Pdpriya62/Lab-dye-Testing-/images/WHITE_20261113_002053.jpg

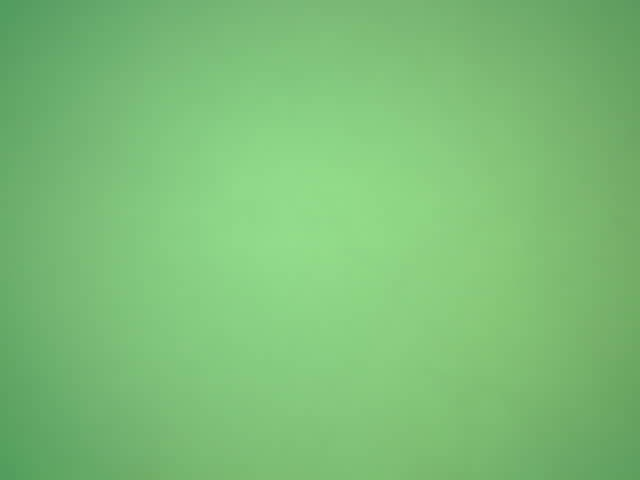
images/WHITE_20261113_002053.jpg
