Pdpriya62/Lab-dye-Testing-/images/WHITE_20261113_001548_annotated.jpg

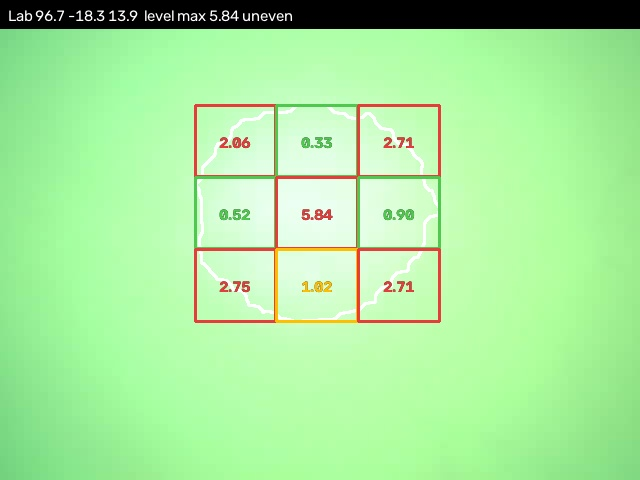
images/WHITE_20261113_001548_annotated.jpg
