Pdpriya62/Lab-dye-Testing-/poster/poster_A3.pdf

# A Low-Cost Multi-Sensor IoT Rig for Process-Aware Lab-Dip Shade Assessment

## 1 Aim

To build a low-cost IoT rig that records every colour reading of a textile lab dip together with the dye-bath and room conditions that produced it, tagged with the sample ID, so that a failed dip can be traced to a likely cause instead of guessed at.

## 2 Problem Statement

A lab dip is a small swatch dyed to the buyer's shade before bulk dyeing.
When a dip is rejected, the recipe is blamed, yet bath temperature, lighting and humidity also shift the shade.
Labs rarely record these beside the colour reading, so a rejected dip has no cause attached. Each extra round wastes dye, water and a day.
Spectrophotometers are costly and do not log the process.

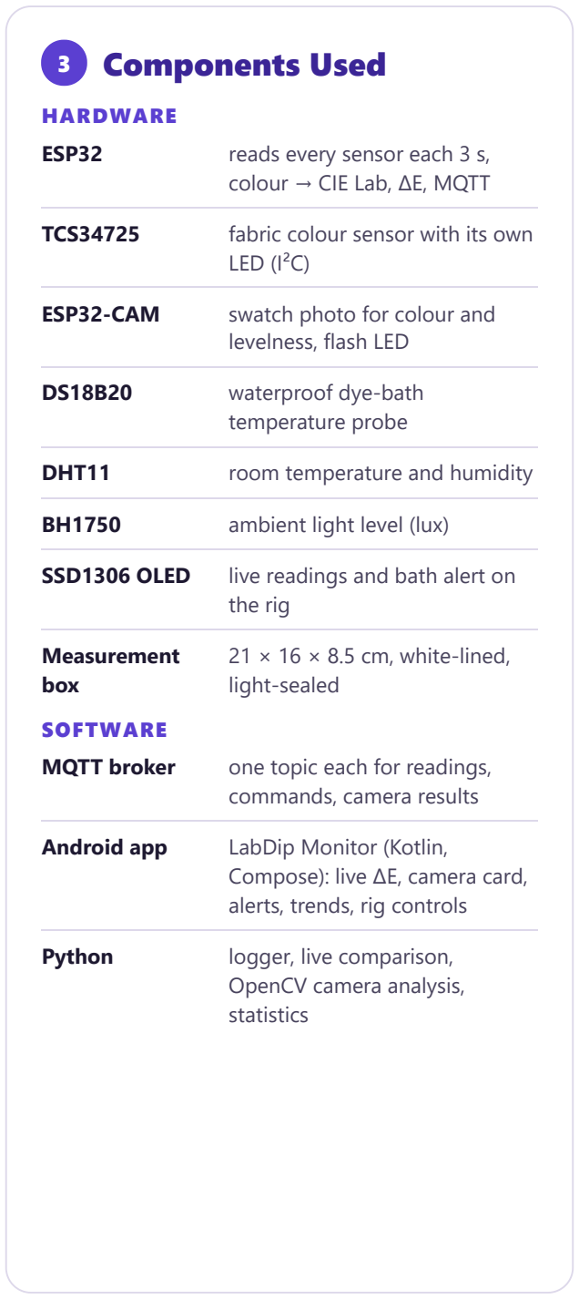
[picture p3: figure]
3 Components Used; HARDWARE; ESP32; reads every sensor each 3 s,; colour → CIE Lab, ΔE, MQTT; LED (I²C); ESP32-CAM; swatch photo for colour and; levelness, flash LED; waterproof dye-bath; temperature probe; DHT11; room temperature and humidity; ambient light level (lux); the rig; Measurement box; 21 × 16 × 8.5 cm, white-lined, light-sealed; SOFTWARE; MQTT broker; one topic each for readings,; commands, camera results; Android app; LabDip Monitor (Kotlin,; Compose): live ΔE, camera card, alerts, trends, rig controls; Python; logger, live comparison,; OpenCV camera analysis, statistics

TCS34725 | fabric colour sensor with its own
SSD1306 OLED | live readings and bath alert on

## 4 Working Principle

Sense
colour, bath,
room, light

ESP32
Lab, ΔE, bath
alert

MQTT
JSON every 3 s

↓ subscribed by ↓
App
ΔE, PASS / FAIL,
commands

Laptop
log, compare,
analyse

ESP32-CAM
photo → Lab,
grid

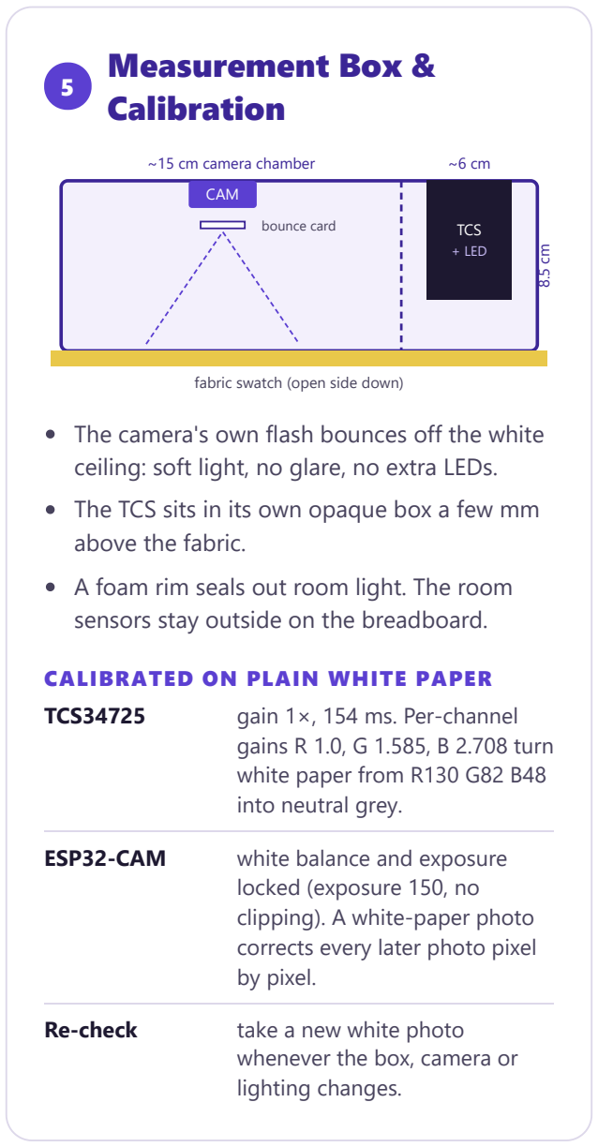
[picture p4: figure]
Measurement Box & Calibration; CAM; bounce card; TCS; + LED; fabric swatch (open side down); ~15 cm camera chamber; above the fabric.; sensors stay outside on the breadboard.; CALIBRATED ON PLAIN WHITE PAPER; TCS34725; gain 1×, 154 ms. Per-channel; gains R 1.0, G 1.585, B 2.708 turn white paper from R130 G82 B48 into neutral grey.; ESP32-CAM; white balance and exposure; locked (exposure 150, no clipping). A white-paper photo corrects every later photo pixel by pixel.; Re-check; take a new white photo; whenever the box, camera or lighting changes.

The camera's own flash bounces off the white ceiling: soft light, no glare, no extra LEDs. The TCS sits in its own opaque box a few mm

A foam rim seals out room light. The room

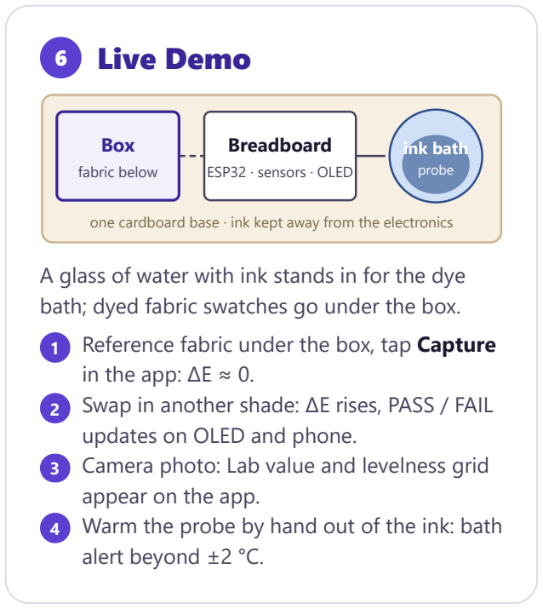
[picture p5: figure]
6 Live Demo; Box; fabric below; Breadboard; ESP32 · sensors · OLED; ink bath probe; in the app: ΔE ≈ 0.; updates on OLED and phone.; appear on the app.; alert beyond ±2 °C.

one cardboard base · ink kept away from the electronics
A glass of water with ink stands in for the dye bath; dyed fabric swatches go under the box.

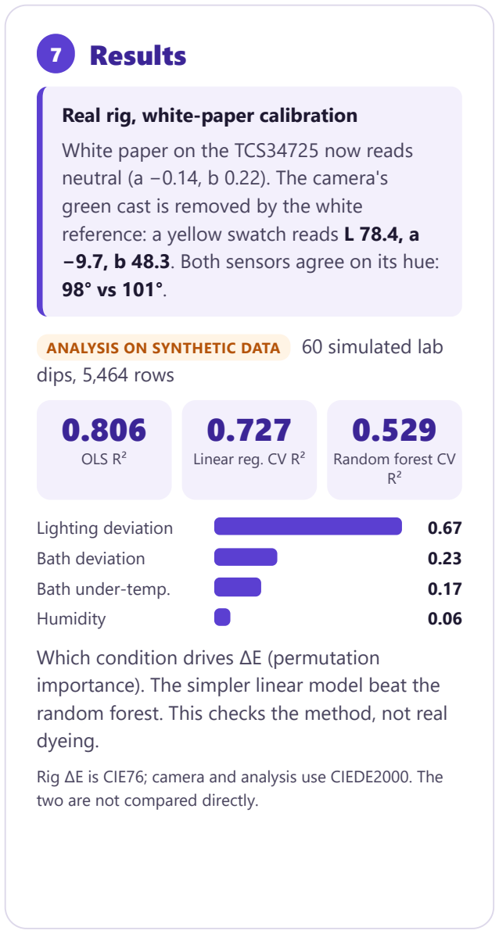
[picture p6: figure]
7 Results; Real rig, white-paper calibration White paper on the TCS34725 now reads neutral (a −0.14, b 0.22). The camera's green cast is removed by the white; dips, 5,464 rows 0.806; OLS R²; Linear reg. CV R²; Random forest CV R²; Lighting deviation; Bath deviation; Bath under-temp.; Humidity; Which condition drives ΔE (permutation; dyeing.; two are not compared directly.

reference: a yellow swatch reads L 78.4, a −9.7, b 48.3. Both sensors agree on its hue:

ANALYSIS ON SYNTHETIC DATA 60 simulated lab

importance). The simpler linear model beat the random forest. This checks the method, not real

Rig ΔE is CIE76; camera and analysis use CIEDE2000. The

TE AM 11
Priyadarshini Prasad
Niharika K P
Nidhi Santosh Nayak
Nischita M
Ganavi J

GUIDE
Aishwarya Singh Gautam
Assistant Professor

IOT DAY · RV UNIVERS I T Y

### Team 11 · School of Computer Science and Engineering, RV University, Bengaluru

Colour: TCS34725 counts ÷ clear channel, scaled to 0–255, corrected by calibration gains, then sRGB → XYZ (D65) → CIE L*a*b*.

1

Target: the reference swatch is captured from the app. Every later swatch gets ΔE and PASS / FAIL against it.

2

Process: bath temperature (alert beyond ±2 °C of set point), room temperature, humidity and light go in the same record.

3

Camera: each photo is corrected pixel by pixel with a white-paper photo, the fabric patch is found automatically and a 3 × 3 grid checks dyeing levelness. Results show on the app's camera card.

4

Analysis: correlation, OLS with ANOVA and cross-validated regression rank the most likely cause of a colour deviation.

5

Safety: every command is range-checked. A missing sensor sends nothing, never a fake value.

6

Reference fabric under the box, tap Capture

Swap in another shade: ΔE rises, PASS / FAIL

Camera photo: Lab value and levelness grid

Warm the probe by hand out of the ink: bath
