Pdpriya62/Lab-dye-Testing-/android-app/frontend.md

# Frontend Design Guidelines

## Visual direction (2026-11-01, supersedes the moss palette and the grey-booth chrome below)
- **Violet glass**, from the reference mock-up `original-45e9928e108b001110bff9260d116afe.webp`: backdrop `Dusk` #1A1236 to `Night` #0D0920, `Orchid` #D58CFF spotlight top right, drifting `Violet` #8B5CF6 and `Indigo` #3B2A8C dye blobs, and a faint rippling woven-thread texture (all in `Backdrop`, drawn on `Canvas`).
- Cards fade from `Glass` (white 8%) to `GlassViolet` (#7C52E0 at 33%), border `GlassEdge`. Text `Ink` #F6F3FF, `InkSoft` #C2BAD8, `InkFaint` #6E6690. Bottom bar `NavSurface` #150F2C.
- Accents, status colours and the N5 `SwatchSurround` stay as below.
- Onboarding: 5 feature slides on every launch, each with an animated orb in the feature's accent colour; the backdrop glow takes that colour.

## Visual direction (2026-10-29, superseded)
The team chose a reference mock-up (dark wellness-dashboard style; image kept outside the repo). The app follows it:
- **Dark only.** Warm near-black backdrop (`Night` #161714 to `Dusk` #22241F) with a soft moss glow (`Moss` #3E4636) behind the top of each screen.
- **Frosted glass cards**: 28 dp corners, white 8% fill fading to 4%, 1 dp white 10% border. No elevation except the alert banner.
- **Round glass icon buttons** (48 dp; selected 56 dp with a brighter rim), as in the mock-up's metric row and onboarding cluster.
- **Type**: screen titles in Instrument Serif italic (38 sp). Everything else in Archivo; numbers in condensed Archivo with tabular figures.
- **Accent per reading**: bath `Ember` #FF6B2C, ambient `Amber` #F7B634, humidity `Aqua` #3FD4EA, light `Lime` #C5E26A. Status colours stay `Pass` #7CCB95, `Marginal` #E3C15A, `Fail` #F08A8A, always with word + icon.
- **Live**: hero card with the metric buttons and a half-circle tick gauge (lit up to the value, long ticks at the limits), then the swatch, then 2×2 reading cards and the Lab card.
- **Trend**: text range tabs ("Last 20 / Last 100 / All") and stacked chart cards (icon, title, range, big value, footer).
- **Bottom bar**: Live, Trend, Samples, Settings; selected label bold.

**What is kept from the booth idea:** the fabric swatch always sits on a neutral N5 grey surround (`SwatchSurround` #777777, R=G=B), so the dark tinted chrome never touches the colour being judged. The grey-chrome token table below no longer applies. Layout, copy, motion and accessibility rules still do.

## Subject and primary job
The app is a pocket version of a **colour-matching viewing booth**. Its one job: tell a dyer at a glance whether this dip matches the target shade, and whether the bath is in range.

## Design idea
Dye labs judge shades in a booth with **neutral grey walls** (ISO 3664, Munsell N-greys) so nothing tints the eye. The UI follows the same rule: all chrome is strictly achromatic. **The only chroma on screen comes from the measured fabric colour and from status.** The swatch is the hero; everything else stays quiet.

Second borrowed object: the **lab-dip card**, where target and sample are mounted side by side. The Live screen shows a split swatch, target half and measured half, with ΔE set across the seam.

## Colour tokens
All chrome tokens are pure greys (R = G = B).

| Token | Light | Dark | Use |
|---|---|---|---|
| `booth` | `#BDBDBD` (≈ N7.5) | `#3B3B3B` (≈ N2.5) | screen background |
| `panel` | `#D4D4D4` | `#4A4A4A` | grouped readings |
| `ink` | `#000000` | `#FFFFFF` | primary text |
| `inkSoft` | `#2E2E2E` | `#D0D0D0` | secondary text (≥ 4.5:1 on `booth`) |
| `rule` | `#9E9E9E` | `#5C5C5C` | hairline dividers |
| `pass` | `#1F6B3A` | `#7CCB95` | PASS text/icon |
| `marginal` | `#7A5A00` | `#E3C15A` | marginal text/icon |
| `fail` | `#9C1C1C` | `#F08A8A` | FAIL, bath alert |

- Status colours appear only as text/icon colour and in the alert banner, never as background washes.
- Every status has a word and an icon (check / tilde / cross), so it reads without colour.
- Turn off Material You dynamic colour: a wallpaper tint would break the neutral-grey rule.

## Typography
One family: **Archivo** (Google Fonts, variable width + weight). Condensed widths suit dense instrument readouts; normal width reads well as body text.

| Role | Style | Size / line |
|---|---|---|
| ΔE readout | width 75, weight 700, tabular figures | 64 / 64 sp |
| Status word | width 100, weight 700 | 22 / 28 sp |
| Reading value | width 87, weight 600, tabular figures | 20 / 24 sp |
| Reading label | weight 400 | 13 / 18 sp |
| Body | weight 400 | 15 / 22 sp |

- Sentence case everywhere. No all-caps labels.
- Units sit next to values: "61.8 °C", "412 lx".
- Tabular figures on every number, so values don't jitter as they update.

## Live screen layout
```
+--------------------------------+
| S001  cotton, reactive red   [gear]   <- top bar; connection dot + "2 s ago"
+--------------------------------+
| +------------+---------------+ |
| |  target    |   measured    | |  split swatch, ~45% of screen height
| |            |               | |
| |         ΔE 1.42            | |  ΔE on the seam; ink picked by swatch luminance
| +------------+---------------+ |
| ~ Marginal   (pass at 1.0 or less)
+--------------------------------+
| Bath       61.8 °C   set 60 ±2 |  row turns `fail` colour + banner on alert
| Lab        52.3  10.1  -4.2    |
| Ambient    27.4 °C   58 %      |
| Light      412 lx              |
+--------------------------------+
```
- Labels left-aligned; values right-aligned in one column.
- Readings are rows inside one `panel`, split by `rule` hairlines, not separate cards.
- Corner radius by role: swatch 4 dp (it is a fabric card), panel 12 dp, buttons full pill.
- No elevation on content. Only the alert banner and dialogs are elevated.
- If no target is set, the swatch is full-width measured colour and ΔE sits at its bottom edge.

## Charts (Vico)
- Data lines in `ink`; threshold and setpoint lines in `inkSoft`, dashed; tolerance band in `rule` at 30% opacity.
- Readings that FAIL get a `fail` dot. No gradient fills under lines.
- Axis titles include units.

## Motion
- One deliberate motion: when a new reading arrives, the measured half of the swatch crossfades to the new colour (300 ms). The ΔE number updates without animation.
- Alert banner slides down from the top (200 ms).
- Respect the system "Remove animations" setting.

## Copy
- Errors state what happened and what to do: "Can't reach broker.hivemq.com. Check Wi-Fi or broker settings."
- Empty states invite action: "No samples yet. Readings appear here once the rig publishes."
- One verb per action across a flow: "Connect" button, "Connected" status.

## Accessibility
- Touch targets ≥ 48 dp.
- TalkBack: swatch announces "Measured colour red 182, green 40, blue 52. Delta E 1.42, marginal."
- Supports font scale up to 200%; Live scrolls rather than clipping.
