Pdpriya62/Lab-dye-Testing-/images/WHITE_20261112_233620_annotated.jpg

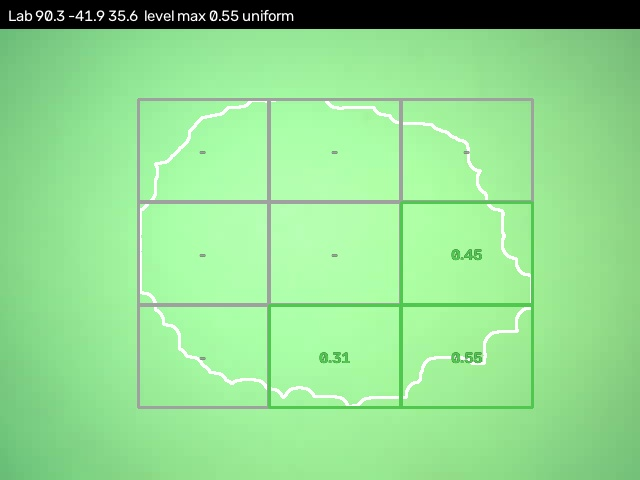
images/WHITE_20261112_233620_annotated.jpg
