Pdpriya62/Lab-dye-Testing-/images/WHITE_20261113_001339.jpg

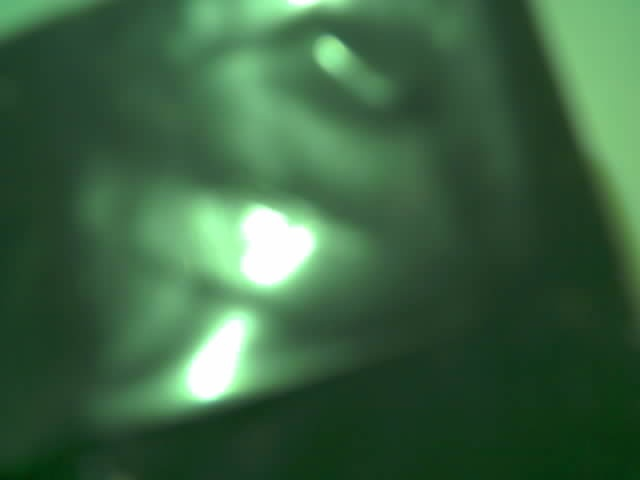
images/WHITE_20261113_001339.jpg
