Pdpriya62/Lab-dye-Testing-/images/WHITE_20261113_001452.jpg

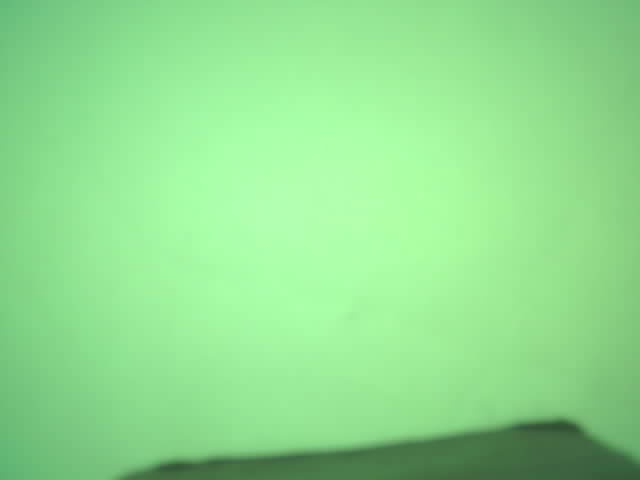
images/WHITE_20261113_001452.jpg
