Pdpriya62/Lab-dye-Testing-/test_real.csv

sample_id | timestamp | L | a | b | ambient_temp | humidity | light_lux | bath_temp | setpoint_c
T1 | 2026-10-29 10:00:00 | 25.2 | 2.1 | -21.8 | 27.5 | 50 | 1190 | 60.1 | 60
T2 | 2026-10-29 10:05:00 | 29.5 | 1.5 | -20.0 | 28.0 | 44 | 1500 | 57.2 | 60
T3 | 2026-10-29 10:10:00 | 44.0 | 60.0 | 38.0 | 28.5 | 62 | 1210 | 59.8 | 60
