Pdpriya62/Lab-dye-Testing-/sample_results.csv

sample_id | session_start | measured_at | fabric | dye_class | shade_name | dye_conc_pct_owf | liquor_ratio | setpoint_c | hold_time_min | target_L | target_a | target_b | measured_L | measured_a | measured_b | tcs_raw_R | tcs_raw_G | tcs_raw_B | tcs_raw_clear | rgb_R | rgb_G | rgb_B | delta_E_76 | delta_E_2000 | result | hold_mean_temp_c | hold_min_temp_c | hold_max_temp_c | hold_temp_std_c | mean_ambient_temp_c | mean_humidity_pct | mean_light_lux | ambient_temp_at_measure_c | humidity_at_measure_pct | light_lux_at_measure | main_deviation_driver | data_source
LD-001 | 2026-10-19 09:30:00 | 2026-10-19 10:44:00 | Viscose | Reactive | Leaf Green | 1.87 | 1:20 | 60 | 28 | 52 | -45 | 28 | 53.33 | -43.51 | 26.92 | 546 | 5482 | 1485 | 8864 | 47 | 145 | 79 | 2.27 | 1.42 | FAIL | 57.18 | 56.12 | 58.06 | 0.42 | 27.5 | 49.6 | 1187 | 27.6 | 47.8 | 1163 | dye_bath_temperature | synthetic
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
