Pdpriya62/Lab-dye-Testing-/results/correlation.png

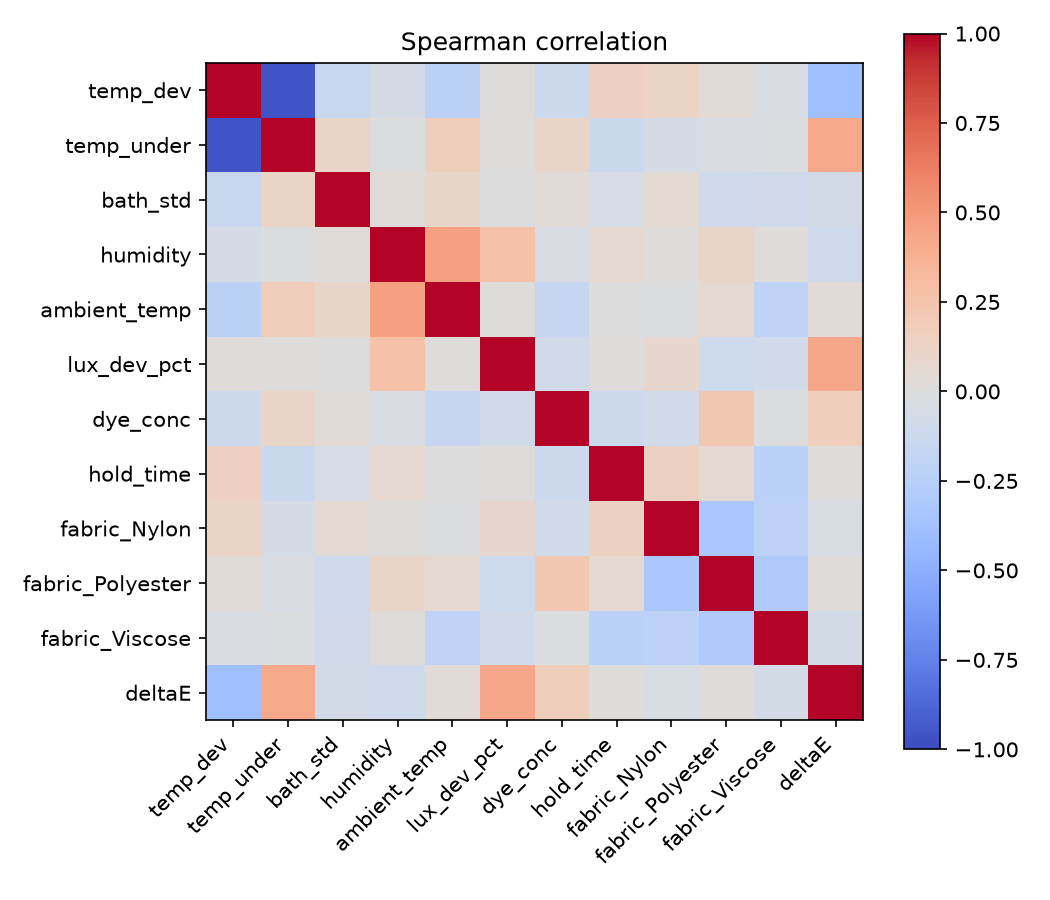
results/correlation.png
