Pdpriya62/Lab-dye-Testing-/results/feature_importance.png

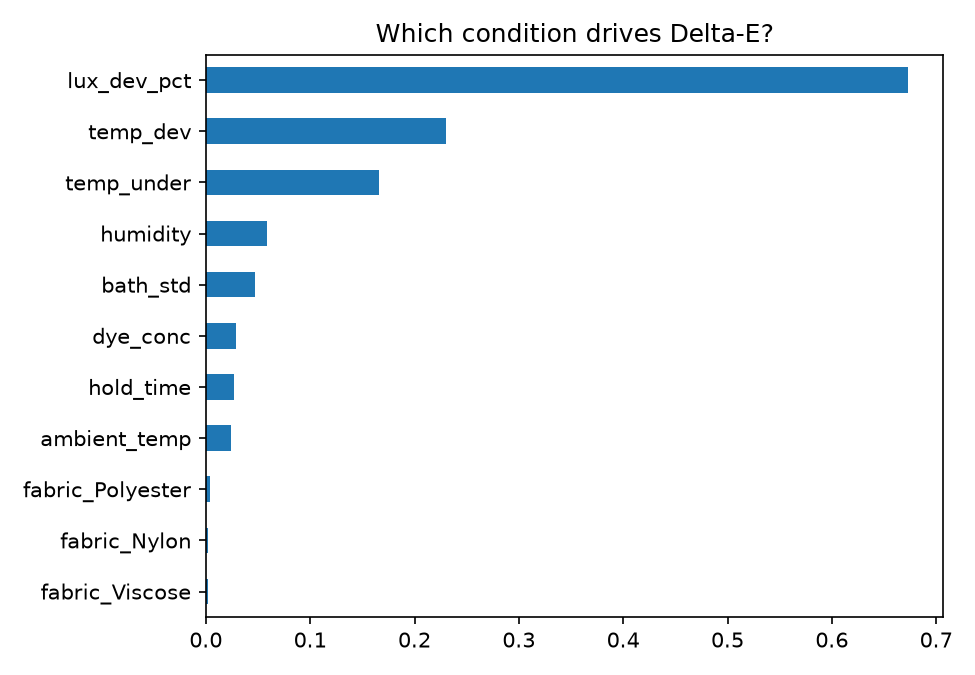
results/feature_importance.png
