Pdpriya62/Lab-dye-Testing-/results/pred_vs_actual.png

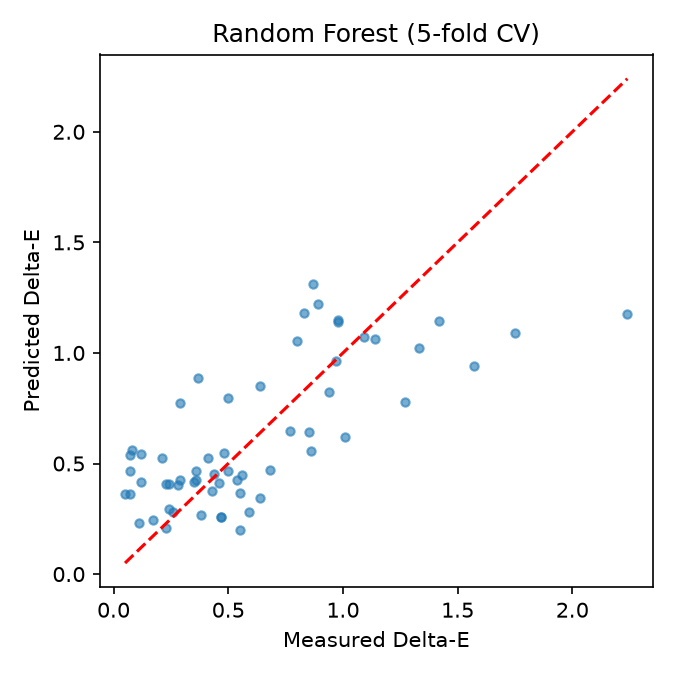
results/pred_vs_actual.png
