Pdpriya62/Lab-dye-Testing-/results/scatter.png

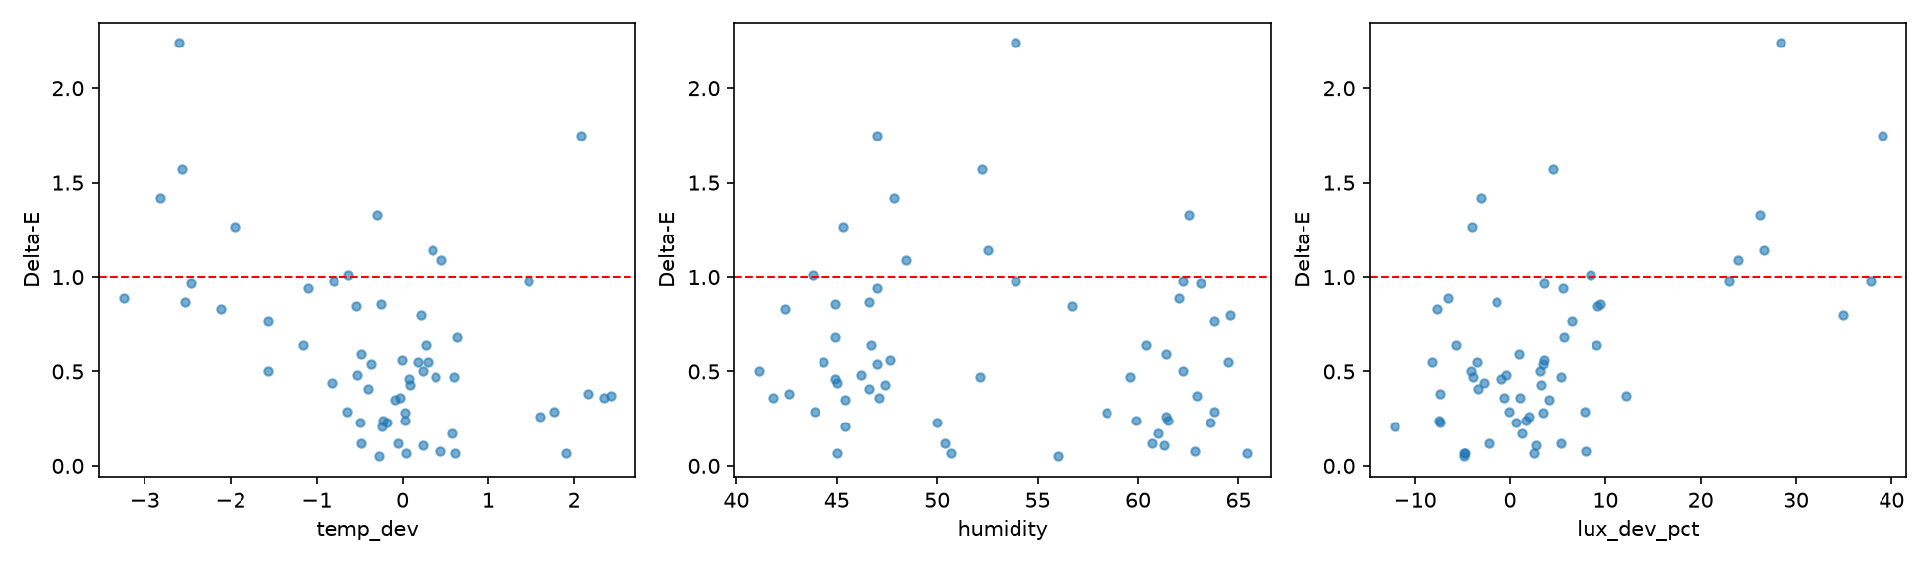
results/scatter.png
