Pdpriya62/Lab-dye-Testing-/lab_dip_esp32/lab_dip_esp32.ino

/*
 * Multi-Sensor IoT Framework for Textile Lab-Dip Testing  (Team 11)
 * ESP32 firmware: reads sensors, computes Delta-E on-device, shows on OLED, publishes JSON via MQTT.
 *
 * Libraries (Arduino Library Manager):
 *   Adafruit TCS34725, DHT sensor library (Adafruit), Adafruit Unified Sensor, BH1750 (by Christopher Laws),
 *   OneWire, DallasTemperature, Adafruit SSD1306, Adafruit GFX, PubSubClient, ArduinoJson
 *
 * Wiring: I2C SDA=GPIO21, SCL=GPIO22 (TCS34725, BH1750, OLED)
 *         DHT11 data=GPIO27
 *         DS18B20 data=GPIO4 with 4.7k pull-up to 3.3V
 *
 * Commands: type them in the Serial Monitor (115200 baud, newline terminated), or publish the same
 * text to MQTT_CMD_TOPIC (the LabDip Monitor app does this). Replies ("OK ..." or "ERR ...") go to
 * serial and to MQTT_ACK_TOPIC.
 * Serial commands:
 *   ID S001            set current Sample ID
 *   CAPTURE            store the CURRENT colour reading as the target shade
 *   TARGET 52.3 10.1 -4.2   set target Lab values manually
 *   BATH 60            set recipe bath temperature (C); alert if outside +/- BATH_TOL
 *   FABRIC cotton / DYE reactive_red / CONC 2.0   optional metadata added to every JSON
 *   PAUSE / RESUME     stop / restart publishing while the fabric is swapped (PAUSE, swap, ID S002, RESUME)
 */
#include <Wire.h>
#include <WiFi.h>
#include <PubSubClient.h>
#include <ArduinoJson.h>
#include <Adafruit_TCS34725.h>
#include <DHT.h>
#include <BH1750.h>
#include <OneWire.h>
#include <DallasTemperature.h>
#include <Adafruit_GFX.h>
#include <Adafruit_SSD1306.h>
#include <math.h>
#include <time.h>
#include "secrets.h"   // WIFI_SSID, WIFI_PASS; copy secrets.example.h if missing

// ---------- USER SETTINGS ----------
const char* MQTT_HOST = "broker.hivemq.com";   // public test broker; use your own for real trials
const int   MQTT_PORT = 1883;
const char* MQTT_TOPIC = "rvu/team11/labdip/data";   // make this unique to avoid other people's traffic
const char* MQTT_CMD_TOPIC = "rvu/team11/labdip/cmd"; // app -> rig commands; keep the same prefix as MQTT_TOPIC
const char* MQTT_ACK_TOPIC = "rvu/team11/labdip/ack"; // rig -> app replies
const char* MQTT_STATUS_TOPIC = "rvu/team11/labdip/status"; // retained "online"; broker sets "offline" (last will) if the rig drops
const unsigned long SAMPLE_INTERVAL_MS = 3000;       // 2-5 s as per methodology
const float BATH_TOL = 2.0;                          // +/- C alert window
// Per-channel calibration gains (fill in after Priya's calibration against reference swatches)
// 2026-11-12: white paper read R130 G82 B48 at GAIN_1X; gains make it neutral grey (130,130,130), red kept at 1.0 to limit clipping
float CAL_R = 1.0, CAL_G = 1.585, CAL_B = 2.708;
// -----------------------------------

#define ONE_WIRE_PIN 4
#define OLED_W 128
#define OLED_H 64

Adafruit_TCS34725 tcs(TCS34725_INTEGRATIONTIME_154MS, TCS34725_GAIN_1X);   // 4X saturated on white paper with the LED on
#define DHT_PIN 27
#define DHT_TYPE DHT11
DHT dht(DHT_PIN, DHT_TYPE);
BH1750 lightMeter;
OneWire oneWire(ONE_WIRE_PIN);
DallasTemperature ds18(&oneWire);
Adafruit_SSD1306 oled(OLED_W, OLED_H, &Wire, -1);
WiFiClient wifiClient;
PubSubClient mqtt(wifiClient);

String sampleId = "S001", fabric = "", dye = "";
float conc = 0;
float targetL = 50, targetA = 0, targetB = 0;
float bathSet = 60.0;
bool haveBath = false;
bool haveTarget = false;   // false until CAPTURE or TARGET; deltaE is against the 50/0/0 placeholder until then
bool tcsFound = false;
bool colourOk = false;     // true only when the last TCS34725 read returned light; no colour = nothing published
unsigned long lastSample = 0;
bool paused = false;       // PAUSE: keep reading and showing, but publish nothing, so a fabric swap is not logged under the old sample ID

struct Reading { float r, g, b, L, a, bb, dE, ambT, hum, press, lux, bath; bool alert; };
Reading cur;

// ---------- Colour maths: sRGB -> XYZ(D65) -> CIE Lab, then CIE76 Delta-E ----------
float lin(float c) { c /= 255.0; return (c <= 0.04045) ? c / 12.92 : pow((c + 0.055) / 1.055, 2.4); }
float fLab(float t) { return (t > 0.008856) ? cbrt(t) : (7.787 * t + 16.0 / 116.0); }
void rgb2lab(float R, float G, float B, float &L, float &a, float &b) {
  float r = lin(R), g = lin(G), bl = lin(B);
  float X = (0.4124564 * r + 0.3575761 * g + 0.1804375 * bl) / 0.95047;
  float Y = (0.2126729 * r + 0.7151522 * g + 0.0721750 * bl) / 1.00000;
  float Z = (0.0193339 * r + 0.1191920 * g + 0.9503041 * bl) / 1.08883;
  float fx = fLab(X), fy = fLab(Y), fz = fLab(Z);
  L = 116.0 * fy - 16.0; a = 500.0 * (fx - fy); b = 200.0 * (fy - fz);
}
float deltaE76(float L1, float a1, float b1, float L2, float a2, float b2) {
  return sqrt((L1 - L2) * (L1 - L2) + (a1 - a2) * (a1 - a2) + (b1 - b2) * (b1 - b2));
}

// ---------- Sensors ----------
float median3(float x, float y, float z) { return max(min(x, y), min(max(x, y), z)); }

void readAll() {
  if (!tcsFound) tcsFound = tcs.begin();   // sensor plugged in after boot
  // Median of 3 reads per channel: one bumped or flickering read no longer moves deltaE (~0.5 s total)
  float ch[3][3];
  int n = 0;
  for (int i = 0; tcsFound && i < 3; i++) {
    uint16_t r = 0, g = 0, b = 0, c = 0;
    tcs.getRawData(&r, &g, &b, &c);
    if (c == 0) continue;   // dark or failed read
    // normalise by clear channel -> 0..255
    ch[n][0] = constrain((float)r / c * 255.0 * CAL_R, 0, 255);
    ch[n][1] = constrain((float)g / c * 255.0 * CAL_G, 0, 255);
    ch[n][2] = constrain((float)b / c * 255.0 * CAL_B, 0, 255);
    n++;
  }
  // A missing or unplugged sensor reads all zeros; publishing that would show a fake black sample
  colourOk = tcsFound && n == 3;
  if (!colourOk) { tcsFound = false; return; }
  float R = median3(ch[0][0], ch[1][0], ch[2][0]);
  float G = median3(ch[0][1], ch[1][1], ch[2][1]);
  float B = median3(ch[0][2], ch[1][2], ch[2][2]);
  cur.r = R; cur.g = G; cur.b = B;
  rgb2lab(R, G, B, cur.L, cur.a, cur.bb);
  cur.dE = deltaE76(cur.L, cur.a, cur.bb, targetL, targetA, targetB);
  float t_amb = dht.readTemperature(), h_amb = dht.readHumidity();
  cur.ambT = t_amb;   // NAN when the DHT11 read fails; publishReading() then leaves the field out
  cur.hum = h_amb;
  float lx = lightMeter.readLightLevel();
  cur.lux = lx < 0 ? NAN : lx;   // BH1750 returns a negative value on error
  ds18.requestTemperatures();
  float t = ds18.getTempCByIndex(0);
  cur.bath = (t == DEVICE_DISCONNECTED_C) ? NAN : t;
  cur.alert = haveBath && !isnan(cur.bath) && fabs(cur.bath - bathSet) > BATH_TOL;
}

// ---------- Display ----------
void showOLED() {
  oled.clearDisplay(); oled.setTextSize(1); oled.setTextColor(SSD1306_WHITE);
  oled.setCursor(0, 0);  oled.printf("ID:%s dE:%.1f", sampleId.c_str(), cur.dE);
  oled.setCursor(0, 11);
  if (colourOk) oled.printf("RGB %d %d %d", (int)cur.r, (int)cur.g, (int)cur.b);
  else oled.print("No colour sensor");
  oled.setCursor(0, 22); oled.printf("Bath: %.1f C", cur.bath);
  oled.setCursor(0, 33); oled.printf("Amb: %.1fC %.0f%%", cur.ambT, cur.hum);
  oled.setCursor(0, 44); oled.printf("Light: %.0f lx", cur.lux);
  oled.setCursor(0, 55); oled.print(cur.alert ? "!! BATH TEMP ALERT !!" : paused ? "PAUSED: swap fabric" : (mqtt.connected() ? "MQTT ok" : "MQTT offline"));
  oled.display();
}

// ---------- Network ----------
void connectWiFi() {
  static bool started = false, timeSet = false;
  static unsigned long lastTry = 0;
  if (WiFi.status() == WL_CONNECTED) {
    if (!timeSet) {
      Serial.print("WiFi ok, IP "); Serial.println(WiFi.localIP());
      configTime(19800, 0, "pool.ntp.org");  // IST = UTC+5:30
      timeSet = true;
    }
    return;
  }
  if (started && millis() - lastTry < 15000) return;   // let the running attempt finish
  lastTry = millis();
  if (!started) {
    // begin() only once: calling it again mid-attempt gives "sta is connecting, cannot set config"
    WiFi.mode(WIFI_STA);
    int n = WiFi.scanNetworks();   // scan before begin(), a scan during a connect attempt also fails
    Serial.printf("Networks seen (%d):\n", n);
    for (int i = 0; i < n; i++) Serial.printf("  '%s' ch%d %ddBm\n", WiFi.SSID(i).c_str(), WiFi.channel(i), WiFi.RSSI(i));
    WiFi.setAutoReconnect(true);
    WiFi.begin(WIFI_SSID, WIFI_PASS);
    started = true;
  } else {
    // 1 = SSID not visible (wrong name or 5 GHz), 4 = connect failed (usually wrong password), 6 = disconnected
    // setAutoReconnect retries on its own; calling reconnect() here gives "sta is connecting, return error"
    Serial.printf("WiFi not connected, status %d, still trying\n", WiFi.status());
    return;
  }
  unsigned long t0 = millis();
  while (WiFi.status() != WL_CONNECTED && millis() - t0 < 10000) delay(250);
}
void connectMQTT() {
  if (mqtt.connected() || WiFi.status() != WL_CONNECTED) return;
  String cid = "labdip-" + String((uint32_t)ESP.getEfuseMac(), HEX);
  // Last will: if the ESP32 loses power or Wi-Fi, the broker publishes "offline" for it after the keep-alive
  if (mqtt.connect(cid.c_str(), MQTT_STATUS_TOPIC, 0, true, "offline")) {
    mqtt.publish(MQTT_STATUS_TOPIC, "online", true);
    mqtt.subscribe(MQTT_CMD_TOPIC);
  }
}
String isoTime() {
  struct tm t;
  if (!getLocalTime(&t, 50)) return "1970-01-01T00:00:00";
  char buf[25]; strftime(buf, sizeof(buf), "%Y-%m-%dT%H:%M:%S", &t); return String(buf);
}
void publishReading() {
  StaticJsonDocument<512> d;
  d["sample_id"] = sampleId; d["timestamp"] = isoTime();
  d["deltaE"] = round(cur.dE * 100) / 100.0;
  d["R"] = (int)cur.r; d["G"] = (int)cur.g; d["B"] = (int)cur.b;
  d["L"] = round(cur.L * 100) / 100.0; d["a"] = round(cur.a * 100) / 100.0; d["b"] = round(cur.bb * 100) / 100.0;
  if (!isnan(cur.ambT)) d["ambient_temp"] = round(cur.ambT * 10) / 10.0;
  if (!isnan(cur.hum)) d["humidity"] = round(cur.hum * 10) / 10.0;
  if (!isnan(cur.lux)) d["light_lux"] = round(cur.lux);
  if (!isnan(cur.bath)) d["bath_temp"] = round(cur.bath * 10) / 10.0;
  d["bath_alert"] = cur.alert;
  d["setpoint_c"] = bathSet;
  d["target_L"] = round(targetL * 100) / 100.0; d["target_a"] = round(targetA * 100) / 100.0; d["target_b"] = round(targetB * 100) / 100.0;
  d["target_set"] = haveTarget;
  if (fabric.length()) d["fabric"] = fabric;
  if (dye.length()) d["dye"] = dye;
  if (conc > 0) d["dye_conc"] = conc;
  char out[512]; size_t n = serializeJson(d, out, sizeof(out));
  mqtt.publish(MQTT_TOPIC, (const uint8_t*)out, n, false);
  Serial.println(out);  // also print to serial so you can log without Wi-Fi
}

// ---------- Commands (serial and MQTT) ----------
// MQTT commands come from a public broker, so every argument is checked before it changes state.
bool okText(const String &v) {   // sample ID, fabric, dye: same whitelist as the app's parser
  if (v.length() < 1 || v.length() > 24) return false;
  for (size_t i = 0; i < v.length(); i++) {
    char ch = v[i];
    if (!(isalnum(ch) || ch == ' ' || ch == '_' || ch == '.' || ch == '-')) return false;
  }
  return true;
}
bool okNum(const String &v, float lo, float hi, float &out) {
  char *end; out = strtof(v.c_str(), &end);
  return v.length() && *end == '\0' && !isnan(out) && out >= lo && out <= hi;
}

String runCommand(String line) {
  line.trim();
  int sp = line.indexOf(' ');
  String cmd = sp < 0 ? line : line.substring(0, sp); cmd.toUpperCase();
  String arg = sp < 0 ? "" : line.substring(sp + 1); arg.trim();
  float v;
  if (cmd == "ID") {
    if (!okText(arg)) return "ERR ID needs 1-24 letters, digits, space, _ . -";
    sampleId = arg; return "OK sample=" + sampleId;
  }
  if (cmd == "CAPTURE") {
    if (!colourOk) return "ERR no colour reading to capture";
    targetL = cur.L; targetA = cur.a; targetB = cur.bb; haveTarget = true;
    char buf[48]; snprintf(buf, sizeof(buf), "OK target Lab=%.2f %.2f %.2f", targetL, targetA, targetB); return buf;
  }
  if (cmd == "TARGET") {
    float L, A, B; char extra;
    if (sscanf(arg.c_str(), "%f %f %f %c", &L, &A, &B, &extra) != 3) return "ERR usage: TARGET L a b";
    if (isnan(L) || isnan(A) || isnan(B) || L < 0 || L > 100 || A < -128 || A > 128 || B < -128 || B > 128)
      return "ERR L 0-100, a and b -128 to 128";
    targetL = L; targetA = A; targetB = B; haveTarget = true;
    char buf[48]; snprintf(buf, sizeof(buf), "OK target Lab=%.2f %.2f %.2f", targetL, targetA, targetB); return buf;
  }
  if (cmd == "BATH") {
    if (!okNum(arg, 0, 130, v)) return "ERR BATH needs 0-130 C";
    bathSet = v; haveBath = true;
    char buf[40]; snprintf(buf, sizeof(buf), "OK bath=%.1f +/- %.1f", bathSet, BATH_TOL); return buf;
  }
  if (cmd == "FABRIC") { if (!okText(arg)) return "ERR FABRIC needs 1-24 letters, digits, space, _ . -"; fabric = arg; return "OK fabric=" + fabric; }
  if (cmd == "DYE")    { if (!okText(arg)) return "ERR DYE needs 1-24 letters, digits, space, _ . -"; dye = arg; return "OK dye=" + dye; }
  if (cmd == "CONC") {
    if (!okNum(arg, 0, 100, v)) return "ERR CONC needs 0-100 %";
    conc = v; char buf[24]; snprintf(buf, sizeof(buf), "OK conc=%.2f", conc); return buf;
  }
  if (cmd == "PAUSE")  { paused = true;  return "OK paused, sample=" + sampleId; }
  if (cmd == "RESUME") { paused = false; return "OK resumed, sample=" + sampleId; }
  return "ERR unknown command";
}

void handleSerial() {
  if (!Serial.available()) return;
  String line = Serial.readStringUntil('\n'); line.trim();
  if (!line.length()) return;
  Serial.println(runCommand(line));
}

void onMqttMessage(char *topic, byte *payload, unsigned int len) {
  if (strcmp(topic, MQTT_CMD_TOPIC) != 0) return;
  if (len == 0 || len > 64) return;   // size cap: real commands are short
  char line[65];
  for (unsigned int i = 0; i < len; i++) {
    if (payload[i] < 32 || payload[i] > 126) return;   // printable ASCII only
    line[i] = (char)payload[i];
  }
  line[len] = '\0';
  String reply = runCommand(String(line));
  Serial.println(String("MQTT> ") + line + " -> " + reply);   // Serial Monitor sees app commands too
  mqtt.publish(MQTT_ACK_TOPIC, reply.c_str());
  if (reply.startsWith("OK")) lastSample = millis() - SAMPLE_INTERVAL_MS;   // publish a fresh reading now
}

void setup() {
  Serial.begin(115200);
  Wire.begin(21, 22);
  tcsFound = tcs.begin();
  if (!tcsFound) Serial.println("TCS34725 not found");
  dht.begin();
  if (!lightMeter.begin()) Serial.println("BH1750 not found");
  ds18.begin();
  if (!oled.begin(SSD1306_SWITCHCAPVCC, 0x3C)) Serial.println("OLED not found");
  oled.clearDisplay(); oled.setCursor(0, 0); oled.setTextColor(SSD1306_WHITE); oled.println("Connecting..."); oled.display();
  connectWiFi();
  mqtt.setServer(MQTT_HOST, MQTT_PORT);
  mqtt.setBufferSize(512);   // default 256 B silently drops full payloads
  mqtt.setCallback(onMqttMessage);
  mqtt.setKeepAlive(10);   // broker notices a dead rig in ~15 s
  Serial.println("Ready. Commands: ID, CAPTURE, TARGET, BATH, FABRIC, DYE, CONC");
}

void loop() {
  handleSerial();
  connectWiFi();   // reconnects when down; once connected it starts NTP (returns at once after that)
  connectMQTT();
  mqtt.loop();
  if (millis() - lastSample >= SAMPLE_INTERVAL_MS) {
    lastSample = millis();
    readAll(); showOLED();
    if (paused) Serial.println("Paused; nothing published (send RESUME)");
    else if (colourOk) publishReading();
    else Serial.println("No colour reading (TCS34725 missing or dark); nothing published");
  }
}
