Pdpriya62/Lab-dye-Testing-/(commit log)

2026-10-29 Add firmware, logger, analysis and live comparision scripts
    [compared_log.csv, model_metrics.csv, sample_results.csv, sensor_readings.csv, test_real.csv]
2026-10-29 chore: move firmware into lab_dip_esp32/ sketch folder
    Arduino IDE requires the .ino to sit in a folder of the same name.
2026-10-29 docs(android-app): add planning docs for LabDip Monitor app
    PRD, app flow, UI guidelines, architecture, database, security, progress and CLAUDE.md for the Kotlin/Compose MQTT client.
2026-10-29 feat(android-app): add LabDip Monitor Android app and firmware MQTT fixes
    App (android-app/): Kotlin + Jetpack Compose subscriber for the rig's MQTT
    topic. Live gauge with split target/measured swatch, trend charts, sample
    history with CSV export, settings with Keystore-encrypted broker password.
    Every payload is validated (size cap, strict decode, range checks, text
    whitelist) before it reaches Room. Includes tools/fake_rig.py for testing
    without hardware, unit tests and in-memory Room tests.
    Firmware: raise PubSubClient buffer to 512 B (the 256 B default silently
    dropped full payloads); publish target_L/a/b and target_set so the app
    knows whether deltaE is measured against a real target;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
2026-10-30 Added AI-Thinker ESP32-CAM with OV2640 camera
2026-10-30 Add ESP32-CAM capture firmware and colour measurement script
2026-10-30 Move camera files into camera folder
2026-11-01 docs: add demo guide, pin check sketch and trial data
    demo.md explains wiring, serial commands, the Python scripts, the app and the demo flow. pin_check scans ESP32 pins for each sensor.
    [compared_log.csv, trials_real.csv]
2026-11-01 feat(android-app): rig controls, rig presence, violet UI and firmware MQTT commands
    App
    - Violet glass re-skin with animated textile backdrop; 5-slide feature intro on every launch
    - Rig controls screen: capture, target Lab, sample ID, fabric, dye, concentration, bath setpoint, reply log
    - Rig presence: red "Rig offline" from MQTT last will or reading age; amber "No new data"
    - Connect over IPv4 (broker IPv6 refused 1883); fix swipe layer showing through Samples cards
    - Release signing from gitignored keystore.properties; release APK 2.3 MB
    Firmware
    - Commands over MQTT (cmd/ack topics) sharing one validated handler with serial
    - Retained online status with last will offline; publish only r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
2026-11-12 fix(firmware): calibrate TCS34725 against white paper and harden reads
    Drop TCS gain to 1X and set CAL_R/G/B so white paper reads neutral (130,130,130). Take the median of 3 reads per channel, and keep retrying Wi-Fi without blocking the loop. Wi-Fi credentials stay in the gitignored secrets.h.
    [lab_dip_esp32.ino]
2026-11-12 feat(camera): halve exposure, OpenCV patch detection, flat-field white reference
    MANUAL_EXPOSURE 300 -> 150: the flash clipped green on white paper. cam_capture.py finds the fabric patch, corrects with a white-paper photo (--flat), measures levelness on a grid and publishes results over MQTT. Adds test_cam_capture.py.
    [cam_capture.py, esp32cam_capture.ino, test_cam_capture.py]
2026-11-12 feat(android-app): camera result card with levelness grid
    Subscribes to the .../cam topic, parses and validates the camera result (CamParser, with tests) and shows Lab, dE2000 and the levelness grid on the Live screen.
2026-11-12 data: add camera captures and new trial logs
    White references and fabric photos from the calibration runs, camera_log.csv, demo_trials.csv. trials_real.csv rows before 2026-11-12 use the old TCS gains.
    [camera_log.csv, compared_log.csv, trials_real.csv]
2026-11-12 docs: measurement box, calibration and ink-bath demo
    Box dimensions and layout, white-paper calibration of the TCS and the camera, BH1750 now measures room light, secrets.h for Wi-Fi, and a rewritten classroom demo with the cardboard layout and bath probe parts.
2026-11-13 feat(firmware): PAUSE and RESUME commands for fabric swaps
    While paused the rig keeps reading and shows PAUSED on the OLED but publishes nothing, so a fabric swap is never logged under the old sample ID.
    [lab_dip_esp32.ino]
2026-11-13 feat(android-app): pause/resume buttons and one-tap sample update
    Rig controls gain a Swap fabric section (Pause, Resume). The Set sample, fabric and dye button now sends the sample ID first, so changing samples no longer needs the separate small Set button.
2026-11-13 feat(camera): hands-free auto capture mode
    --every N captures and publishes every N seconds while the rig is publishing and skips while it is paused or offline. --flat latest picks the newest white reference. 15/15 self-tests pass.
    [cam_capture.py, test_cam_capture.py]
2026-11-13 docs: demo launcher, updated demo steps, pitch script and A3 poster
    start_demo.bat starts the logger and the camera in auto mode. classroom_demo.md covers Pause/Resume swaps and the auto camera. pitch.md is a 3-minute spoken pitch. poster/ holds the A3 poster (HTML source and print PDF).
2026-11-13 data: demo-run camera captures and trial logs (2026-11-13)
    [camera_log.csv, compared_log.csv, demo_trials.csv]
2026-11-14 chore: keep only white references in images/, add new demo logs
    Auto-captured camera photos are now gitignored (start_demo.bat makes two every ~14 s); the WHITE_*.jpg references stay tracked. --flat latest now picks the newest white reference by its timestamped name, since a checkout resets file times. camera_log.csv and demo_trials.csv gain the latest demo rows.
    [camera_log.csv, demo_trials.csv]
